bagilder/Nixie/seven seg binary decoder/7seg_pinout.gif

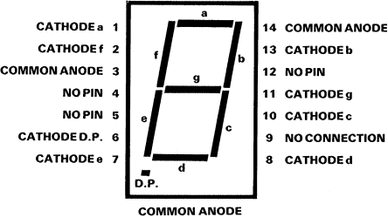
seven seg binary decoder/7seg_pinout.gif
