bagilder/Nixie/PCB/nixie_legacy-power/nixie_legacy-power.kicad_pcb

## KiCad design PCB/nixie_legacy-power/nixie_legacy-power.kicad_pcb (2021-11-17, an earlier design)

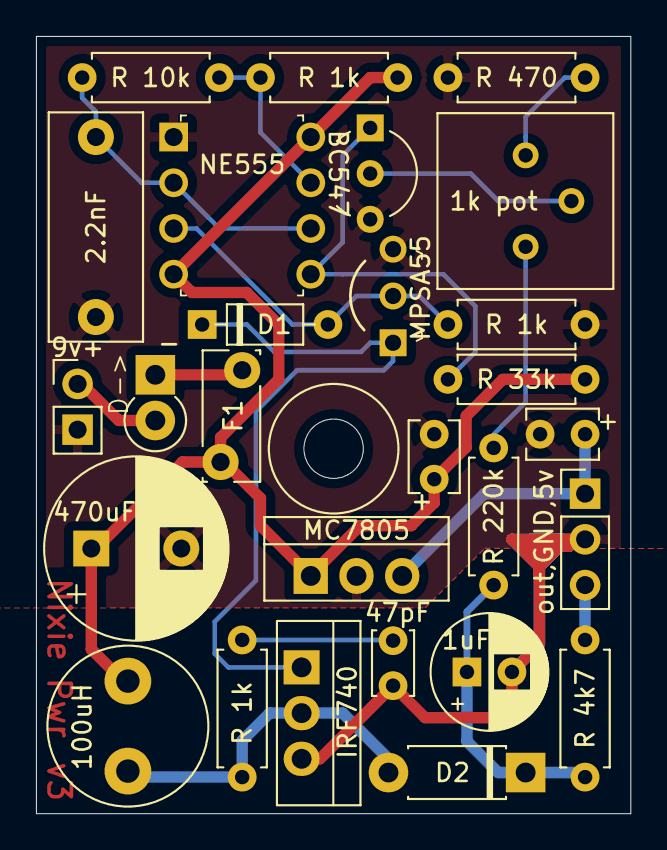
[picture p2: board nixie_legacy-power.kicad_pcb from above]

Board: 2 copper layers, 33.0 x 43.2 mm, 27 parts (0 on the bottom side), 17 nets.

Parts:
1k pot: 1k; Potentiometer_Bourns_3386P_Vertical
1uF: 1u; CP_Radial_D6.3mm_P2.50mm
2.2nF: 2.2n; C_Disc_D12.5mm_W5.0mm_P10.00mm
5v: 220nTANT; C_Disc_D3.8mm_W2.6mm_P2.50mm
9v+: Barrel_Jack; PinHeader_1x02_P2.54mm_Vertical
47pF: 47p; C_Disc_D3.4mm_W2.1mm_P2.50mm
100uH: 100u; L_Radial_D8.7mm_P5.00mm_Fastron_07HCP
470uF: 470u; CP_Radial_D10.0mm_P5.00mm
+: 220nTANT; C_Disc_D3.8mm_W2.6mm_P2.50mm
BC547: BC547; TO-92_Inline_Wide
D1: D_ALT; D_DO-35_SOD27_P7.62mm_Horizontal
D2: D; D_DO-41_SOD81_P7.62mm_Horizontal
D->: D; D_DO-41_SOD81_P2.54mm_Vertical_KathodeUp
F1: Polyfuse; Fuse_Bourns_MF-RG300
IRF740: IRF740; TO-220-3_Vertical
MC7805: MC7805CT-BP; TO-220-3_Vertical
MPSA55: MPSA55-AP; TO-92-3_Formed_Leads
NE555: NE555P; DIP-8_W7.62mm
R 1k, R 1k#2, R 1k#3: 1k; R_Axial_DIN0207_L6.3mm_D2.5mm_P7.62mm_Horizontal
R 4k7: 4.7k; R_Axial_DIN0207_L6.3mm_D2.5mm_P7.62mm_Horizontal
R 10k: 10k; R_Axial_DIN0207_L6.3mm_D2.5mm_P7.62mm_Horizontal
R 33k: 33k; R_Axial_DIN0207_L6.3mm_D2.5mm_P7.62mm_Horizontal
R 220k: 220k; R_Axial_DIN0207_L6.3mm_D2.5mm_P7.62mm_Horizontal
R 470: 470; R_Axial_DIN0207_L6.3mm_D2.5mm_P7.62mm_Horizontal
out,GND,: HEADER_3; PinHeader_1x03_P2.54mm_Vertical

Connections:
5v: 5v.1, MC7805.3, out,GND,.1
9v: 100uH.1, 470uF.1, +.1, F1.2, MC7805.1, NE555.4, NE555.8, R 1k#3.2, R 33k.1
GND: 1uF.2, 2.2nF.2, 5v.2, 9v+.2, 47pF.2, 470uF.2, +.2, BC547.3, IRF740.3, MC7805.2, MPSA55.3, NE555.1, R 1k#2.2, R 470.2, out,GND,.2
unnamed: 2.2nF.1, NE555.2, NE555.6, R 10k.1
unnamed: 47pF.1, R 1k.2
unnamed: 1uF.1, D2.1, R 4k7.2, R 220k.2
unnamed: D1.1, IRF740.1, MPSA55.1
unnamed: D1.2, MPSA55.2, NE555.3, R 1k#2.1
unnamed: 100uH.2, D2.2, IRF740.2, R 1k.1
unnamed: D->.1, F1.1
unnamed: 9v+.1, D->.2
unnamed: BC547.1, NE555.5, R 33k.2
unnamed: 1k pot.2, BC547.2
unnamed: NE555.7, R 1k#3.1, R 10k.2
unnamed: 1k pot.1, R 220k.1
unnamed: 1k pot.3, R 470.1
output: R 4k7.1, out,GND,.3
