bagilder/Nixie/PCB/nixie_legacy-digit/nixie_legacy-digit.kicad_pcb

## KiCad design PCB/nixie_legacy-digit/nixie_legacy-digit.kicad_pcb (2021-11-17, an earlier design)

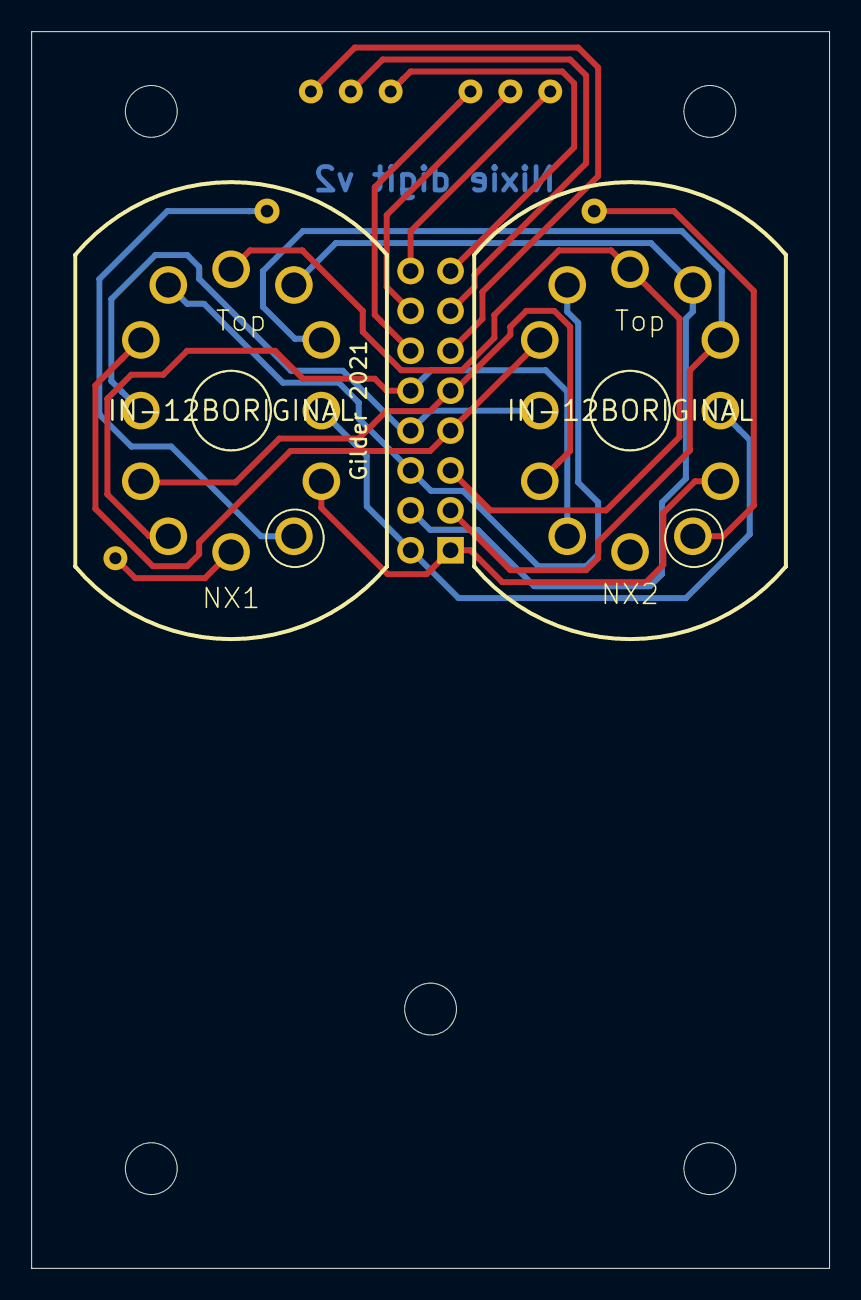
[picture p3: board nixie_legacy-digit.kicad_pcb from above]

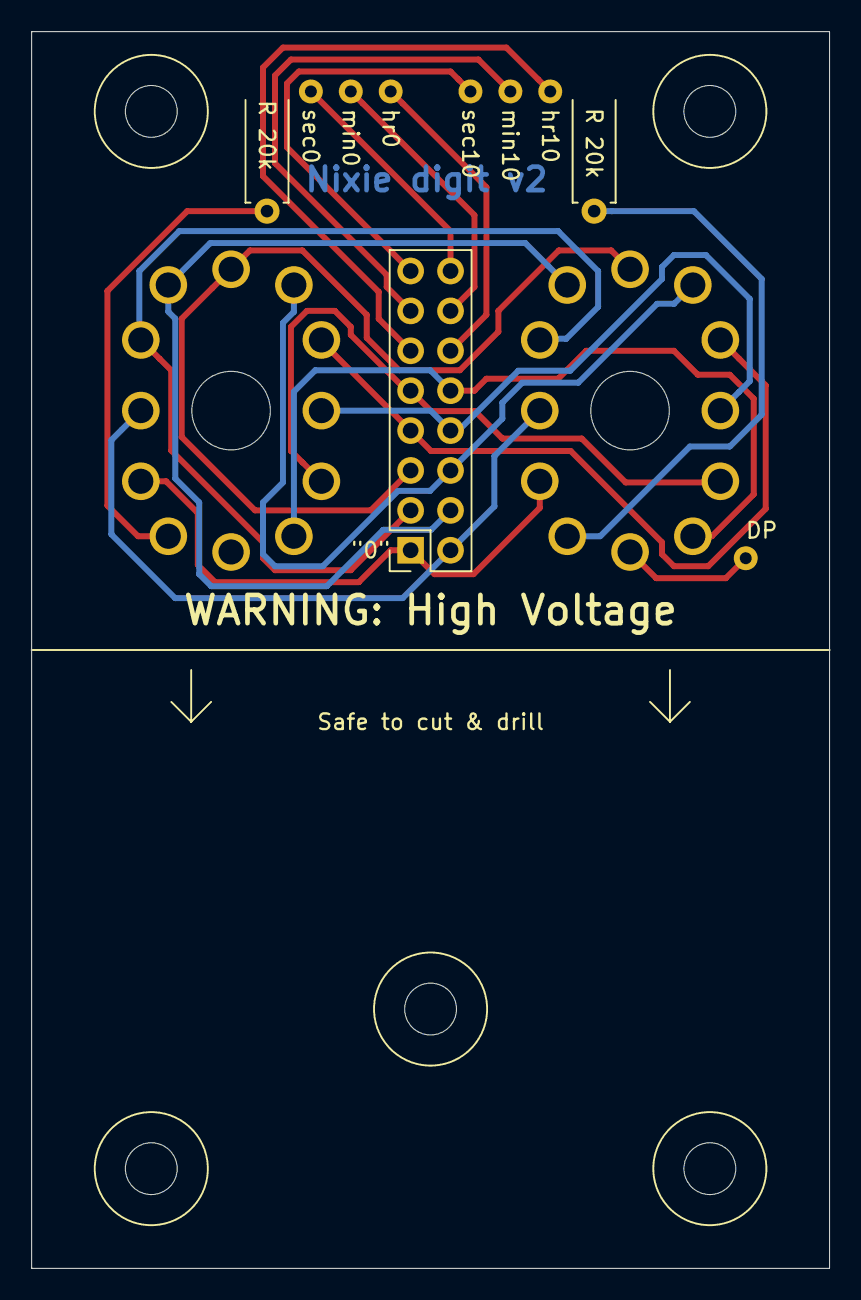
[picture p4: board nixie_legacy-digit.kicad_pcb from below]

Board: 2 copper layers, 50.8 x 78.7 mm, 12 parts (8 on the bottom side), 19 nets.

Parts:
"0": HEADER_16; PinHeader_2x08_P2.54mm_Vertical
DP: HEADER_1; Single_pad-1x1
NX1, NX2: IN-12BORIGINAL; nixies-us-IN-12-DSUB
R 20k, R 20k#2: 20k; R_Axial_DIN0207_L6.3mm_D2.5mm_P7.62mm_Horizontal
hr0, hr10: HEADER_1; Single_pad-1x1
min0, min10: HEADER_1; Single_pad-1x1
sec0, sec10: HEADER_1; Single_pad-1x1

Connections:
0: "0".2, NX1.0, NX2.0
1: "0".9, NX1.1, NX2.1
2: "0".10, NX1.2, NX2.2
3: "0".7, NX1.3, NX2.3
4: "0".8, NX1.4, NX2.4
5: "0".5, NX1.5, NX2.5
6: "0".6, NX1.6, NX2.6
7: "0".3, NX1.7, NX2.7
8: "0".4, NX1.8, NX2.8
9: "0".1, NX1.9, NX2.9
unnamed: NX1.A, R 20k#2.2
unnamed: DP.1, NX1.LHDP
unnamed: NX2.A, R 20k.2
digit1msb: "0".12, hr10.1
digit2: "0".11, hr0.1
digit3: "0".14, min10.1
digit4: "0".13, min0.1
digit5: "0".16, sec10.1
digit6lsb: "0".15, sec0.1
