bagilder/Nixie/(commit log)

2021-07-25 Added PCB files
    [nixie_legacy-demux.kicad_pcb, nixie_legacy-demux.sch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]
2021-07-26 Fixing analog pin conflict for random seed (future-proofing)
    [NIXIE_LEGACY_CODE.cpp]
2021-07-31 updated NIXIE_LEGACY_CODE.cpp to uint8_t from int in most of the extraneous cases. if this is a double push, i missed a few last time
    [NIXIE_LEGACY_CODE.cpp]
2021-07-31 added i2c_rtc_test.c to test interfacing with RX8025 rtc module
    [nixie_legacy-demux.sch, nixie_legacy-power.kicad_pcb]
2021-07-31 added new_rtc.cpp to integrate legacy mux code with new rtc timekeeping. this commit contains only the i2c control to interface with the rtc module
2021-08-05 new_rtc.cpp now generally works on hardware. added pullup resistor to /inta to prevent ping spamming. bugs remaining in time set, especially switching 12/24 hr
    [new_rtc.cpp]
2021-08-06 Updating power PCB to v2 to include 5v regulator and support post hole
    [nixie_legacy-power-B_Cu.gbr, nixie_legacy-power-B_Fab.gbr, nixie_legacy-power-B_Mask.gbr, nixie_legacy-power-B_SilkS.gbr, nixie_legacy-power-Edge_Cuts.gbr, nixie_legacy-power-F_Cu.gbr, nixie_legacy-power-F_Fab.gbr, nixie_legacy-power-F_Mask.gbr]
2021-08-06 Demux circuit schematic now complete with RTC (including 1Hz interrupt pin)
    [nixie_legacy-demux.sch]
2021-08-06 new_rtc.cpp moved digit bcd pin4 to digital pin 0 (which has a conflict with Rx but this won't matter if serial comm is turned off) to stay away from port c and keep all on same side of chip. have no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
    [new_rtc.cpp]
2021-08-06 Demux pcb rough layout blocking. no routing yet
2021-08-07 Adding demux PCB v1: uses resistor network for 100k, has npn on board but pnp is on digit board
    [nixie_legacy-demux-B_Cu.gbr, nixie_legacy-demux-B_Fab.gbr, nixie_legacy-demux-B_Mask.gbr, nixie_legacy-demux-B_SilkS.gbr, nixie_legacy-demux-Edge_Cuts.gbr, nixie_legacy-demux-F_Cu.gbr, nixie_legacy-demux-F_Fab.gbr, nixie_legacy-demux-F_Mask.gbr]
2021-08-07 Schematic of digit board v1: pnp on board
    [nixie_legacy-digit.kicad_pcb, nixie_legacy-digit.sch]
2021-08-08 power pcb updated. wrote my name on the silk screen :)
    [nixie_legacy-power-B_Cu.gbr, nixie_legacy-power-B_Fab.gbr, nixie_legacy-power-B_Mask.gbr, nixie_legacy-power-B_SilkS.gbr, nixie_legacy-power-Edge_Cuts.gbr, nixie_legacy-power-F_Cu.gbr, nixie_legacy-power-F_Fab.gbr, nixie_legacy-power-F_Mask.gbr]
2021-08-08 demux pcb v2, has MPSA92 transistors on this board instead of digit board, reducing connector to 16 pins instead of 18.
    [nixie_legacy-demux-B_Cu.gbr, nixie_legacy-demux-B_Fab.gbr, nixie_legacy-demux-B_Mask.gbr, nixie_legacy-demux-B_SilkS.gbr, nixie_legacy-demux-Edge_Cuts.gbr, nixie_legacy-demux-F_Cu.gbr, nixie_legacy-demux-F_Fab.gbr, nixie_legacy-demux-F_Mask.gbr]
2021-08-08 digit pcb v1. extra long so that it can fit in my specific clock enclosure. made a "safe to cut" zone so it can be shortened for other applications
    [nixie_legacy-digit-B_Cu.gbr, nixie_legacy-digit-B_Fab.gbr, nixie_legacy-digit-B_Mask.gbr, nixie_legacy-digit-B_SilkS.gbr, nixie_legacy-digit-Edge_Cuts.gbr, nixie_legacy-digit-F_Cu.gbr, nixie_legacy-digit-F_Fab.gbr, nixie_legacy-digit-F_Mask.gbr]
2021-08-08 digit pcb updated. added breakout for left decimal point (for 4-digit clocks)
    [nixie_legacy-digit-B_Cu.gbr, nixie_legacy-digit-B_Fab.gbr, nixie_legacy-digit-B_Mask.gbr, nixie_legacy-digit-B_SilkS.gbr, nixie_legacy-digit-Edge_Cuts.gbr, nixie_legacy-digit-F_Cu.gbr, nixie_legacy-digit-F_Fab.gbr, nixie_legacy-digit-F_Mask.gbr]
2021-08-10 demux pcb update: footprint for rtc was sop 16 instead of sop 14. rerouted power traces. shortened to 3.75"
    [nixie_legacy-demux-B_Cu.gbr, nixie_legacy-demux-B_Fab.gbr, nixie_legacy-demux-B_Mask.gbr, nixie_legacy-demux-B_SilkS.gbr, nixie_legacy-demux-Edge_Cuts.gbr, nixie_legacy-demux-F_Cu.gbr, nixie_legacy-demux-F_Fab.gbr, nixie_legacy-demux-F_Mask.gbr]
2021-08-12 power pcb. added input polarity protection diode and rearranged board to fit accordingly. removed ground plane from high voltage zone. (recommit)
    [nixie_legacy-power-B_Cu.gbr, nixie_legacy-power-B_Fab.gbr, nixie_legacy-power-B_Mask.gbr, nixie_legacy-power-B_SilkS.gbr, nixie_legacy-power-Edge_Cuts.gbr, nixie_legacy-power-F_Cu.gbr, nixie_legacy-power-F_Fab.gbr, nixie_legacy-power-F_Mask.gbr]
2021-08-19 digit pcb update. removed flood fill copper
    [nixie_legacy-digit-B_Cu.gbr, nixie_legacy-digit-B_Fab.gbr, nixie_legacy-digit-B_Mask.gbr, nixie_legacy-digit-B_SilkS.gbr, nixie_legacy-digit-Edge_Cuts.gbr, nixie_legacy-digit-F_Cu.gbr, nixie_legacy-digit-F_Fab.gbr, nixie_legacy-digit-F_Mask.gbr]
2021-08-19 all PCB gerbers zip add/update
2021-09-01 SR_drive_test.c initial commit. allows testing a pair of tubes using 74hc595 shift registers by repurposing the SPI pins. directly driving each tube, two tubes per 595
2021-09-03 SR_drive_test.c updated to include final blanking stage. changed to support power demux of the pairs if the data outputs of the SR are bussed between digits
2021-09-05 SR_drive_test.c future proofed to support 3-to-8 mux to distribute latch pin for eventual distribution of serial data. also fixed ghosting issue and blanking timing on pair demux scheme
    [SR_drive_test.c]
2021-11-17 -power board: updated 7805 footprint to better fit piece, "A55" instead of "A56", 9v input pad shape swap so that ground makes sense -digit board: added resistor value, vertical connector, correct pi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
    [nixie_legacy-digit-B_Cu.gbr, nixie_legacy-digit-B_Fab.gbr, nixie_legacy-digit-B_Mask.gbr, nixie_legacy-digit-B_SilkS.gbr, nixie_legacy-digit-Edge_Cuts.gbr, nixie_legacy-digit-F_Cu.gbr, nixie_legacy-digit-F_Fab.gbr, nixie_legacy-digit-F_Mask.gbr]
2023-03-08 new_rtc: tried and failed to fix hour roll animation
    [new_rtc.cpp]
2023-03-08 new_rtc: set looper magicnumber had uint underflow, needed int. still resets to :12 at roll for some reason tho
    [new_rtc.cpp]
2023-05-18 new_rtc: squished 24hr fancy roll animation bug. 24hr should now be functional. -only fancy roll animation active, haven't looked at 12hr bugs but who cares
    [new_rtc.cpp]
2023-05-18 new_rtc: fixed tube ghosting by turning off serial debugging you dummy. 24hr gucci
    [new_rtc.cpp]
2025-08-01 SR baseline: redesign for shift registers. written but untested
    [SR baseline.cpp, SR_drive_test.c]
2025-08-21 SR ino: all 3 digit sets display correctly. hour animate works.
    [SR_baseline.ino]
2026-03-31 nixie SR: fixed hour set bug. animate starts at top of :59 instead of at rollover
    [SR_baseline.ino]
2026-09-13 SR_redesign: 595 shift register redesign. surface mount everything. first pass
    [SR_VFD_board.kicad_sch, SR_digit_board.kicad_pcb, SR_digit_board.kicad_sch]
2026-09-15 SR redesign: hour and minute sections have vertical ribbon headers. need to rearrange seconds. putting in breaks in the board but maybe that's a dumb idea idk
    [SR_digit_board.kicad_pcb]
2026-09-15 SR redesign - added buttons. copypasted seconds
    [SR_digit_board.kicad_pcb, SR_digit_board.kicad_sch]
2026-09-15 SR redesign - added atmega support components, still need xtal footprint
    [SR_digit_board.kicad_pcb, SR_digit_board.kicad_sch]
2026-09-15 SR redesign - most of the layout seems to be there. need a power supply
    [SR_digit_board.kicad_pcb, SR_digit_board.kicad_sch]
2026-09-16 SR redesign - possible complete board with gerbers. included power supply on boards. traces bridge regions. might need to revisit if the ribbon cable spacing is different or if we want to nudge the t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
    [SR_digit_board-B_Cu.gbr, SR_digit_board-B_Mask.gbr, SR_digit_board-B_Paste.gbr, SR_digit_board-B_Silkscreen.gbr, SR_digit_board-Edge_Cuts.gbr, SR_digit_board-F_Cu.gbr, SR_digit_board-F_Mask.gbr, SR_digit_board-F_Paste.gbr]
